g8kmh/RP2040_OOK48_LCD/README.md

# RP2040 OOK48 LCD

## Archived

Please use the G4EML master.

No further work on this fork.

73 Lehane
G8KMH
