g8kmh/RP2040_OOK48_LCD/PCB/PCB.png

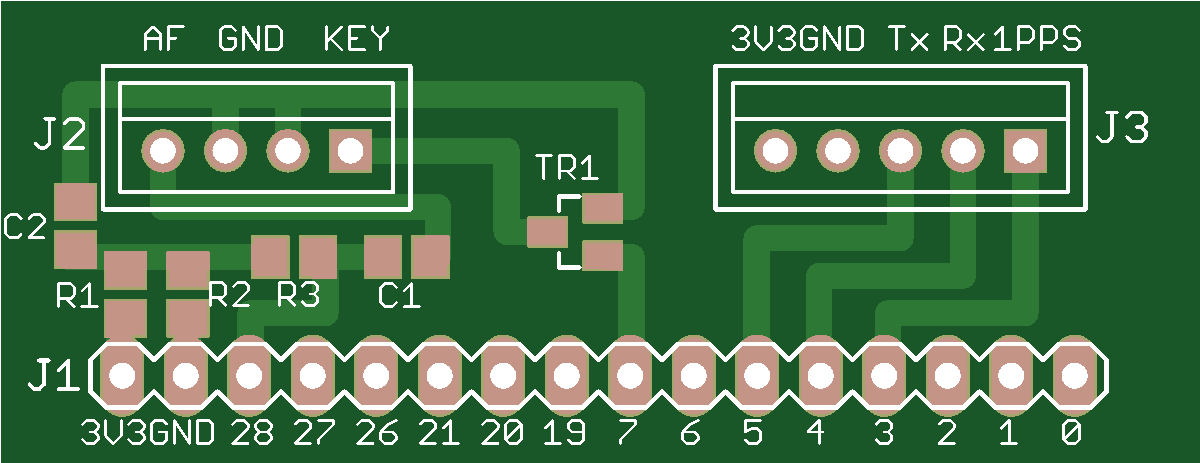
PCB/PCB.png
