g8kmh/RP2040_OOK48_LCD/PCB/BOM.xls

 | BOM for OOK48 Interface
Ident | Value | Quantity | Notes
R1 R2 | 47K 0805 | 2
R3 | 1K5 0805 | 1
C1 | 100nF 0805 | 1
C2 | 10uF 0805 | 1
TR1, TR2 | DMN3404L-7 | 2 | 30V 4A. Other N Chan types if preferred.
J1 | 16 PIN 2.54mm Straight Header | 1
J2 | 4 Pin Header | 1 | JST-XH series. Or other types if preferred
J3 | 5 Pin Header | 1 | JST-XH series. Or other types if preferred
