g8kmh/RP2040_OOK48_LCD/Documents/Schematic.pdf

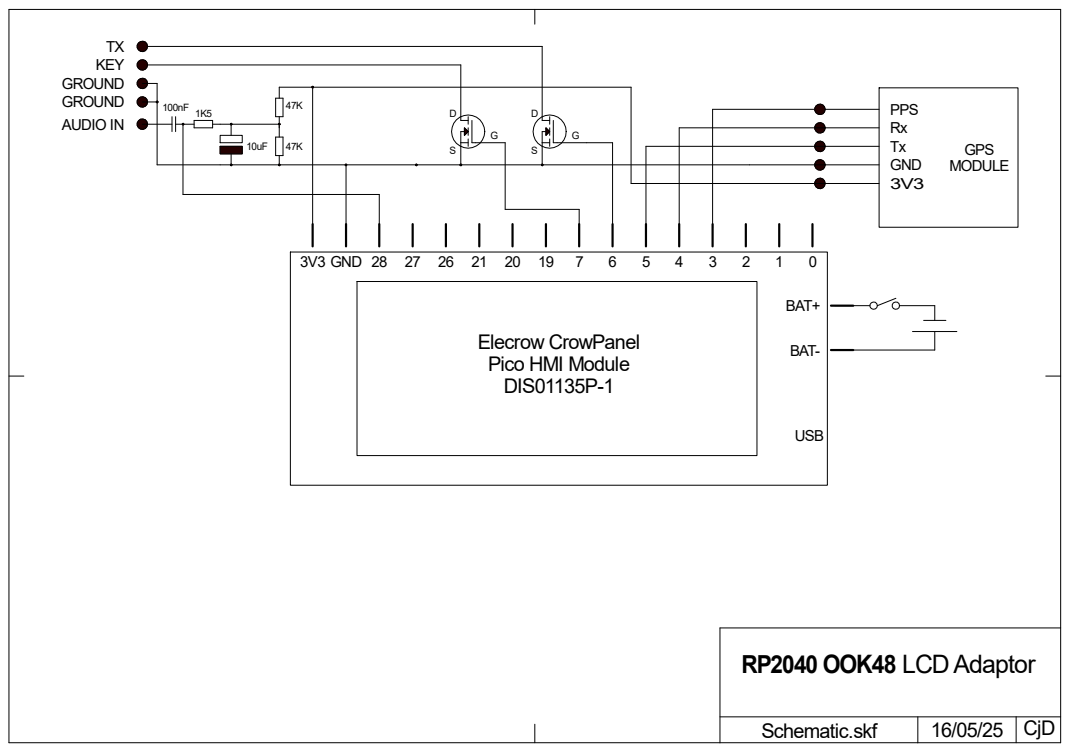
[picture p2: page 1]
RP2040 OOK48 LCD Adaptor; Schematic.skf; CjD; 3V3 GND 28; AUDIO IN; GROUND; USB; GPS; GND; MODULE; PPS; KEY; BAT+; BAT-

Elecrow CrowPanel
Pico HMI Module
DIS01135P-1
