g8kmh/RP2040_OOK48_LCD/(commit log)

2025-05-19 Initial Upload
    Initial Upload
    [OOK48_Interface.brd]
2025-05-21 Add PCB data
    [BOM.xls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]
2025-05-24 Add Message Clear when screen is calibrated
2025-05-25 Change error character to Tilde.
    [RP2040_OOK48_LCD.ino]
2025-05-29 Add TX Output Pin
2025-05-29 Add Tx Output
    [OOK48_Interface.brd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]
2025-05-29 update BOM
    [BOM.xls]
2025-05-31 add battery voltage display
2025-06-05 Remove battery voltage
    Battery voltage function removed.
    It was causing errors in the decoding due to ADC problems.
    Will revisit at a later date
    [DEFINES.h, DMA.ino, GUI.ino, Rx.ino, Tx.ino, globals.h]
